dritory/f3_backplane/(commit log)

2025-05-25 no DRC errors
    [connector.kicad_sch, f3_backplane.kicad_pcb, f3_backplane.kicad_sch, nvme.kicad_sch, sata.kicad_sch]
2025-09-26 revision V1.1
    [bom.csv, designators.csv, f3_backplane.kicad_pcb, positions.csv]
